mk0000001/ESP32-2424S012-MagSafe-Case/reports/V18/README.md

# V18 프로젝트 보고서와 조립 애니메이션

# V18 Project report and assembly animation

[보고서 PDF / Report PDF](ESP32-2424S012_V18_PROJECT_REPORT_KO_EN.pdf) · [수정용 원문 / Editable source](PROJECT_REPORT.ko-en.md)

[한영 조립 영상 / Korean-English assembly video](../../media/V18/assembly.mp4) · [GIF](../../media/V18/assembly.gif) · [조립 설명 / Assembly instructions](../../docs/ASSEMBLY.ko.md)

한국어 다음 영어 순서. CAD 형상 변경 없음. V18 실물 출력 검증은 남아 있다.

Korean followed by English. CAD geometry is unchanged. Physical V18 print validation remains outstanding.
