mk0000001/ESP32-2424S012-MagSafe-Case/media/V18/README.md

# V18 조립 영상

# V18 Assembly animation

[MP4](assembly.mp4) · [GIF](assembly.gif) · [SRT](assembly.ko-en.srt) · [보고서 / Report](../../reports/V18/)

약 47초, 한글 다음 영어 자막. 실제 V18 케이스 CAD의 조립 동작을 설명한다. 전자부품은 설명용 외형이다.

Approximately 47 seconds, with Korean followed by English captions. It illustrates native V18 case CAD assembly; electronics are explanatory envelopes.
