mk0000001/ESP32-2424S012-MagSafe-Case/cad/V18/README.md

# cad/V18

V18 FreeCAD 원본. BREP는 조립 좌표이고 STL 출력 좌표와 다름.
