mk0000001/ESP32-2424S012-MagSafe-Case/hardware/battery/photos/README.md

# hardware/battery/photos

사용자가 제공한 배터리 식별 사진. 이전 조립물이며V18 출력 사진이 아님.
