mk0000001/ESP32-2424S012-MagSafe-Case/hardware/ESP32-2424S012/photos/README.md

# hardware/ESP32-2424S012/photos

사용자가 제공한 ESP32-2424S012 PCB 사진.
