mk0000001/ESP32-2424S012-MagSafe-Case/cad/V18/brep/README.md

# cad/V18/brep

V18 케이스5종과 조임툴1종의 정밀 BREP. 단위mm,조립 좌표.
