mk0000001/ESP32-2424S012-MagSafe-Case/hardware/battery/YCJ-603048.md

# 배터리 모델 식별

## 사진으로 확인한 값

- 라벨:`YCJ 603048`
- 정격전압:3.7V
- 표시용량:880mAh
- 원산지 표기:`MADE IN CHINA`
- 사용자 실측:50×30×5mm. V18 설계에 적용한 값이다.
- 적색/흑색 전선과 흰색2핀 커넥터가 부착되어 있고, 노란 절연 테이프 안쪽에 소형 기판이 보인다.
- KC마크와 인증 번호 형식의 인쇄가 있으나, 사진의 마지막 문자까지 확정 판독하거나 인증 유효성을 별도로 검증한 것으로 표시하지 않았다.

사진:[정면 라벨](photos/battery-label-user.jpg) · [장착 모습](photos/battery-installed-user.jpg) · [측면](photos/battery-side-user.jpg)

사진은 사용자가 제공한 이전 조립물이다. V18 출력 완료 사진을 의미하지 않는다.

## 같은 사양의 유통 제품 후보

**Coms UB917 — 603048 리튬폴리머 충전지,3.7V,880mAh.**

Coms 공식 목록과 [공식 상세 이미지](https://comsmart.co.kr/productnew/sub21/UB917.jpg)에 모델 코드·전압·용량이 일치한다. 공식 상세 이미지에는 보호회로 내장, 크기30×50×6mm, 전선 길이50mm, 인증표기`ZU10701-17002G`가 실려 있다.

사용자의 주문서/포장에UB917이 표시된 것은 확인하지 못했으므로 **실물 라벨 모델은YCJ603048**, **UB917은 유통 모델 후보**로 기록한다. 같은 공통 모델 코드가 모든 판매자의 커넥터·극성·외형 두께를 보증하지 않는다.

## 치수 차이와 V18

| 기준 | 길이×폭×두께 |
|---|---|
| 사용자 실측/케이스 설계 | 50×30×5mm |
| Coms UB917 판매자 상세 자료 | 50×30×6mm |

V18은 사용자가 장착한5mm 실측 배터리의 흔들림을 줄이기 위해 받침을0.5mm 높였다. 공급자가6mm라고 명시한 대체품은 현재CAD로 검증한5mm 배터리와 구분한다. 사진 속 라벨로부터 실제 두께를 재측정한 것으로 표시하지 않는다.

## 출처

- 사용자 제공 사진,2026-10-30.
- [Coms 공식 상품 목록](https://www.comsmart.co.kr/cmart/shop/list.php?ca_id=f04070)
- [Coms UB917 공식 상세 이미지](https://comsmart.co.kr/productnew/sub21/UB917.jpg)
- [디바이스마트 동일 코드 판매 목록](https://www.devicemart.co.kr/goods/view?no=15808378):유통명 교차 확인용.
