mk0000001/ESP32-2424S012-MagSafe-Case/cad/V17/brep/README.md

# cad/V17/brep

V18 재생성에 사용하는 고정 V17 기준 형상. 출력 추천 버전은 V18.
