mk0000001/ESP32-2424S012-MagSafe-Case/hardware/battery/photos/battery-side-user.jpg

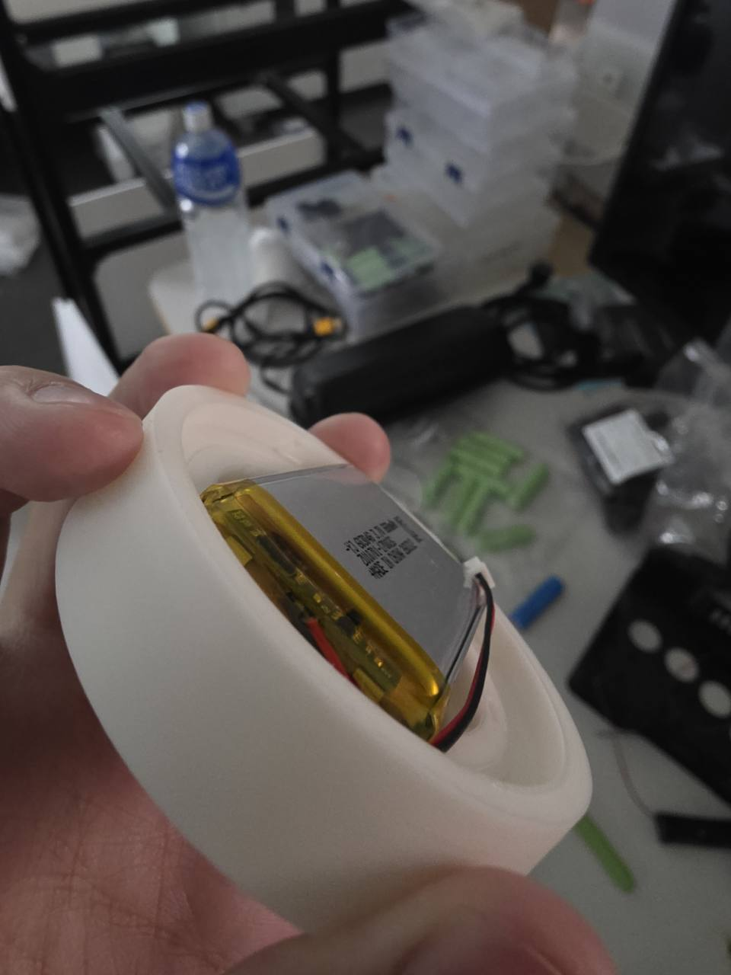
hardware/battery/photos/battery-side-user.jpg
