mk0000001/ESP32-2424S012-MagSafe-Case/hardware/ESP32-2424S012/photos/pcb-user.jpg

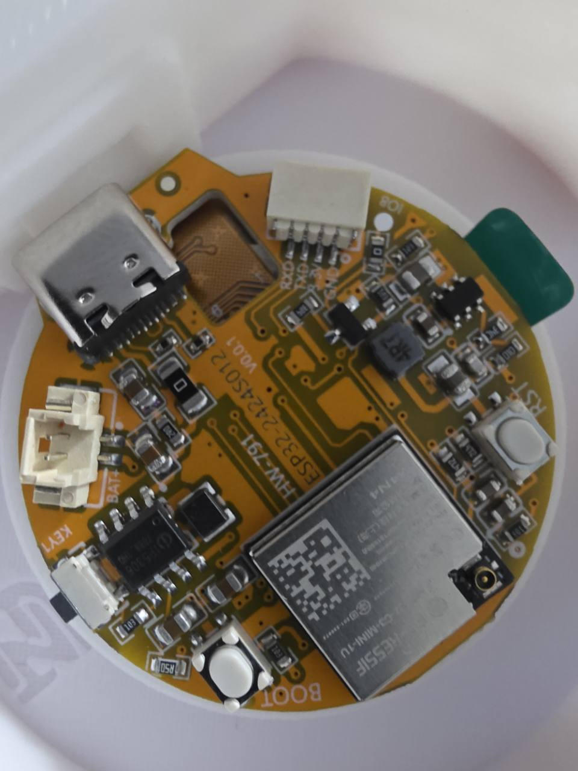
hardware/ESP32-2424S012/photos/pcb-user.jpg
