mk0000001/ESP32-2424S012-MagSafe-Case/cad/V18/ESP32_2424S012_FIT_V18.FCStd

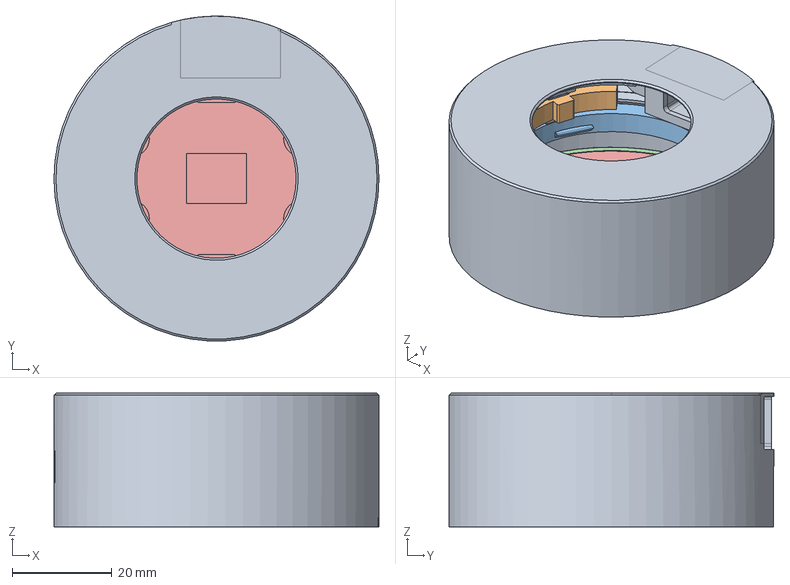
[picture p10: CAD file, 2026-10-30]
cad/V18/ESP32_2424S012_FIT_V18.FCStd
65.3 x 65.3 x 26.8 mm
V18 본체 — USB-C 안쪽 가림벽
V18 보드 받침틀 — V17 호환
V18 보드 고정 링 — 3점 홈 / V17 호환
V18 바깥 뚜껑 — V17 호환
V18 배터리 받침판 — 돌기 +0.5mm / 50.6×30.6mm
