mk0000001/ESP32-2424S012-MagSafe-Case/print/V18/BODY_V18_PRINT.stl

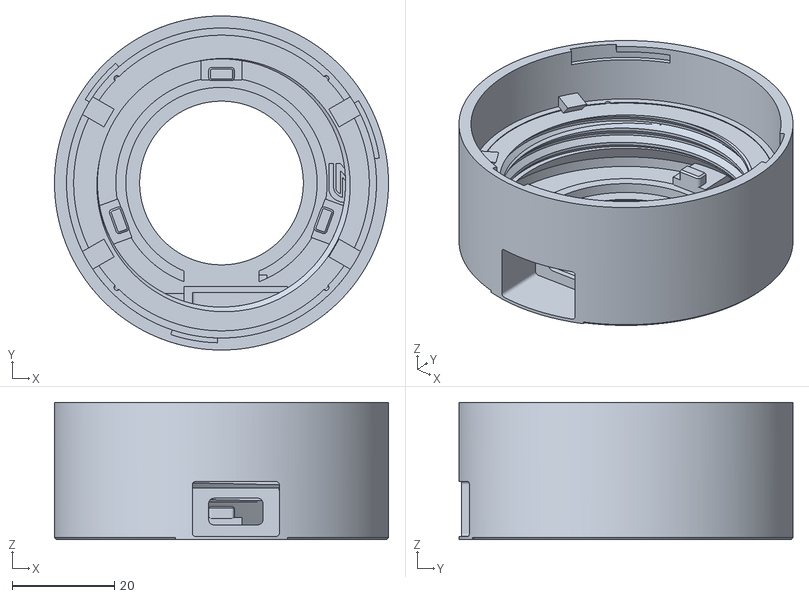
[picture p11: CAD file, 2026-10-30]
print/V18/BODY_V18_PRINT.stl
65.3 x 65.3 x 26.8
