mk0000001/ESP32-2424S012-MagSafe-Case/print/V18/RING_TOOL_3POINT_V18_PRINT.stl

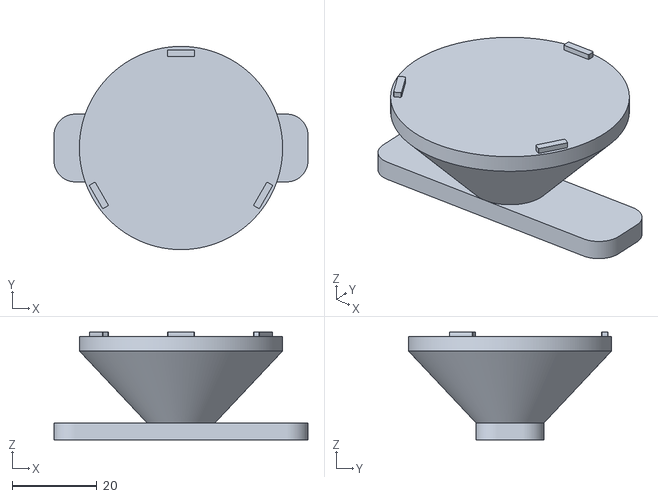
[picture p12: CAD file, 2026-10-30]
print/V18/RING_TOOL_3POINT_V18_PRINT.stl
60.0 x 48.0 x 25.5
