mk0000001/ESP32-2424S012-MagSafe-Case/print/V18/BATTERY_TRAY_INNER_V18_PRINT.stl

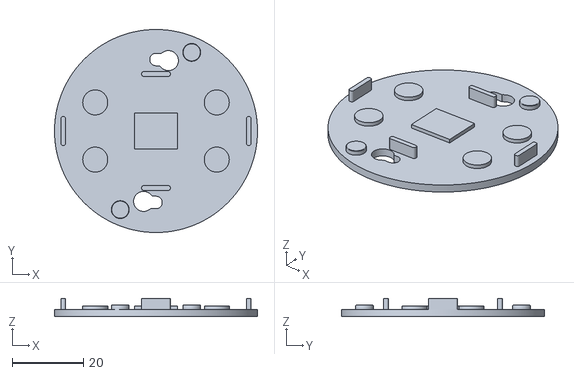
[picture p13: CAD file, 2026-10-30]
print/V18/BATTERY_TRAY_INNER_V18_PRINT.stl
56.8 x 56.8 x 5.10
