mk0000001/ESP32-2424S012-MagSafe-Case/print/V18/BOARD_SUPPORT_FRAME_V18_PRINT.stl

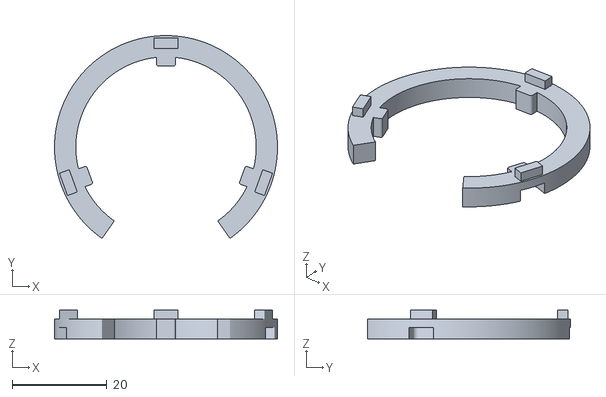
[picture p14: CAD file, 2026-10-30]
print/V18/BOARD_SUPPORT_FRAME_V18_PRINT.stl
47.0 x 42.8 x 6.08
