mk0000001/ESP32-2424S012-MagSafe-Case/print/V18/MAGSAFE_OUTER_LID_V18_PRINT.stl

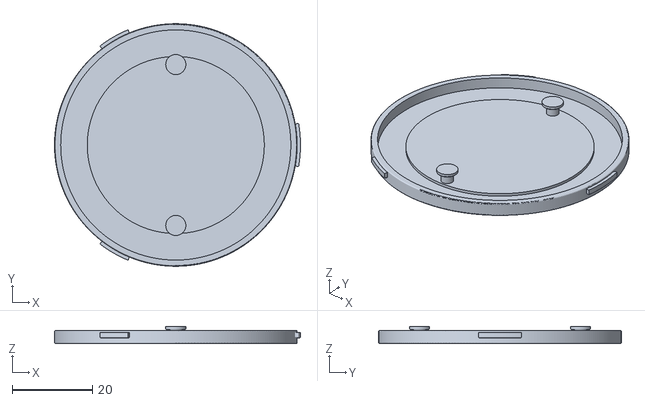
[picture p15: CAD file, 2026-10-30]
print/V18/MAGSAFE_OUTER_LID_V18_PRINT.stl
61.1 x 60.3 x 4.27
