mk0000001/ESP32-2424S012-MagSafe-Case/print/V18/SCREW_RETAINING_RING_3POINT_V18_PRINT.stl

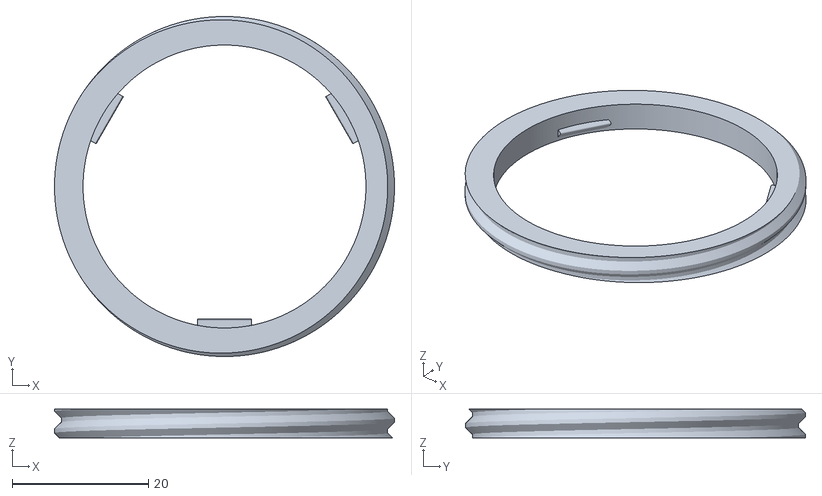
[picture p16: CAD file, 2026-10-30]
print/V18/SCREW_RETAINING_RING_3POINT_V18_PRINT.stl
50.0 x 50.0 x 4.20
