mk0000001/ESP32-2424S012-MagSafe-Case/print/V18/README.md

# print/V18

V18 출력 STL 6개. 각각1개,100% 배율. 본체와 배터리 받침판이 V17에서 변경됨.
