mk0000001/ESP32-2424S012-MagSafe-Case/docs/ASSEMBLY.ko.md

# V18 조립 설명

# V18 Assembly instructions

[조립 영상 / Assembly video](../media/V18/assembly.mp4) · [반복 GIF / Looping GIF](../media/V18/assembly.gif) · [프로젝트 보고서 / Project report](../reports/V18/ESP32-2424S012_V18_PROJECT_REPORT_KO_EN.pdf)

각 단계는 한국어 다음에 영어로 적었다. 회전 방향은 반드시 해당 단계에서 지정한 면에서 본다.

Each step is written in Korean first, then English. Observe every rotation from the viewing side specified in that step.

## 1 본체에 보드 넣기

### Seat the display module

화면을 아래, 노란 PCB를 위로 놓고 USB-C를 본체 충전 구멍에 맞춰 앉힌다.

Place the screen face down with the yellow PCB facing up. Align the USB-C socket with the opening in the body.

## 2 보드 받침틀 넣기

### Fit the board support frame

BOARD_SUPPORT_FRAME의 깊은 홈 3개를 본체 돌기 3개에 맞춰 끝까지 내려 앉힌다.

Align the three deep slots in BOARD_SUPPORT_FRAME with the three body keys and lower the frame onto its seats.

## 3 나사 링으로 보드 고정

### Secure the board with the threaded ring

링을 손으로 먼저 나사산에 맞춘다. 툴 돌기 3개를 링 홈에 끼우고 기기 뒤에서 보아 시계 방향으로 손으로 조인다. 닿아 멈추면 그만 조이고 툴을 빼낸다.

Start the ring on the thread by hand. Engage the three tool pegs and turn clockwise when viewed from the rear of the device. Stop when seated and remove the tool.

## 4 자석 스티커 붙이기

### Attach the magnet sticker

실제 자석이 홈에 들어가는지 먼저 확인한다. 안쪽 배터리 받침판 아래쪽에 붙이고, 흡착 면이 바깥 뚜껑을 향하도록 한다.

Check that the actual magnet fits the recess before bonding it to the underside of the inner battery tray, with its active face toward the outer lid.

## 5 안쪽 배터리 받침판 잠그기

### Lock the inner battery tray

분리한 바깥 뚜껑의 안쪽을 위로 놓는다. 큰 구멍 2개로 기둥 머리를 통과시킨 다음, 뚜껑 안쪽에서 보아 시계 방향 10도로 돌려 좁은 곡선 홈에 건다. 눌러 끼우는 스냅 구조가 아니다.

Place the detached outer lid with its inside facing up. Pass the two post heads through the large holes, then rotate the tray clockwise by 10 degrees when looking into the lid. The heads capture the narrow curved slots; this is a bayonet, not a press-fit snap.

## 6 배터리 넣고 연결

### Fit and connect the battery

50×30×5 mm 배터리를 가이드 안에 놓고 보드 배터리 커넥터에 연결한다. 전선을 안쪽으로 정리해 테두리와 잠금 홈에 끼이지 않게 한다. 배터리를 눌러 찌그러뜨리며 닫지 않는다.

Place the 50×30×5 mm battery inside the guide and connect it to the board. Route the leads inward, clear of the rim and locking tracks. Do not close the case by compressing the battery.

## 7 뚜껑 전체 잠그기

### Lock the complete lid

넓은 돌기 1개를 본체의 넓은 진입 홈에 맞춰 넣는다. 기기 뒤에서 보아 시계 방향 20도로 멈추는 곳까지 돌린다.

Align the one wider lid lug with the wider entry in the body. Turn the complete lid clockwise by 20 degrees when viewed from the rear of the device, up to the stop.

## 열 때

## Disassembly

뚜껑 전체는 기기 뒤에서 보아 반시계 방향 20도, 안쪽 받침판은 분리한 뚜껑 안쪽에서 보아 반시계 방향 10도로 연다. 보드 링을 풀기 전에는 뚜껑과 배터리를 꺼내고 배터리 커넥터를 분리한다.

Open the complete lid counterclockwise by 20 degrees as viewed from the device rear. Open the inner tray counterclockwise by 10 degrees as viewed into the detached lid. Remove the lid and battery and disconnect the battery before loosening the board ring.

안쪽 받침판과 뚜껑 전체는 바라보는 면이 서로 반대다. 보드·배터리·자석·커넥터는 영상에서 위치 설명용 외형이며, 배터리 커넥터 연결은 자막으로 안내한다. V18 실물 체결력은 아직 시험 전이다.

The inner tray and complete lid are viewed from opposite sides. Board, battery, magnet and connector models in the animation are explanatory envelopes. Battery connection is described in captions rather than mechanically animated. Physical V18 fastening force has not yet been tested.
