mk0000001/ESP32-2424S012-MagSafe-Case/media/V18/assembly.gif

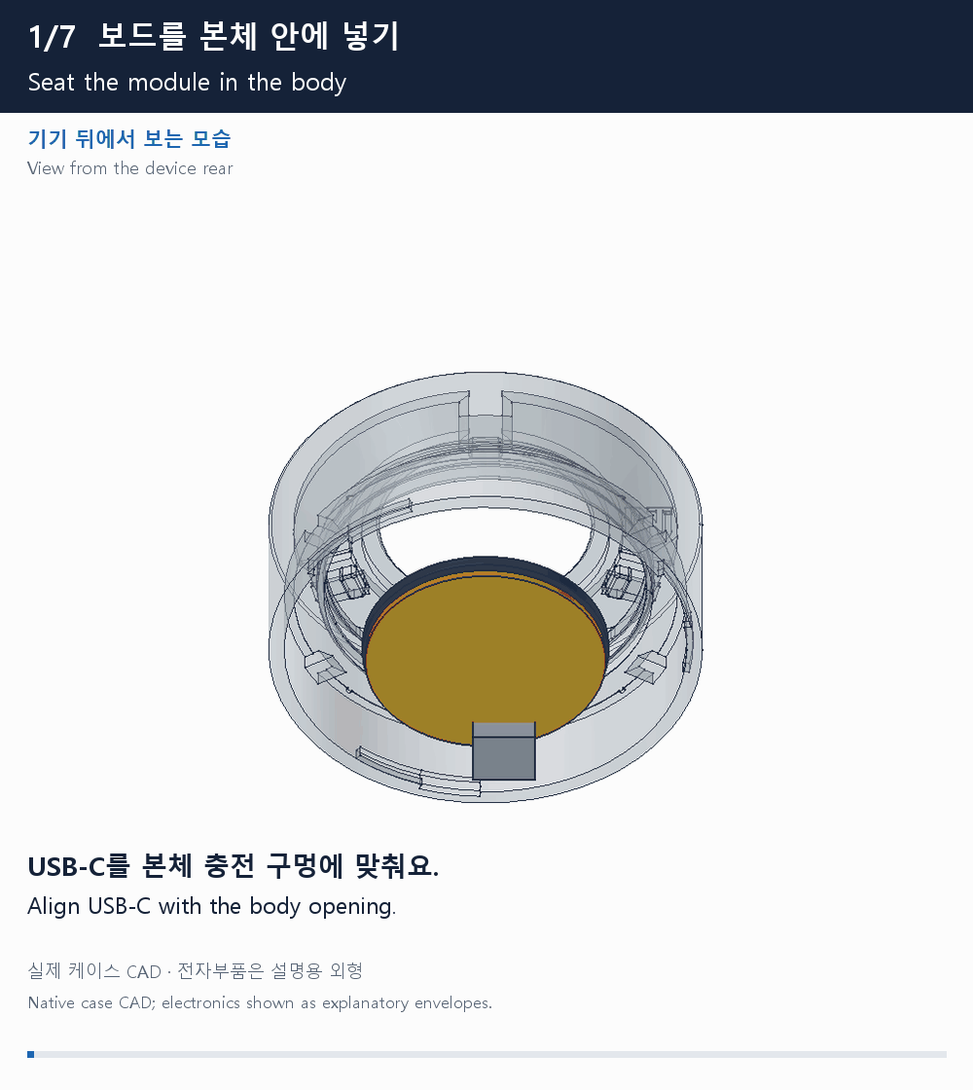
media/V18/assembly.gif
