mk0000001/ESP32-2424S012-MagSafe-Case/CHANGELOG.md

# 변경 이력

## V18 문서 보완 · 2026-10-31

- 10쪽 한국어 다음 영어 프로젝트 보고서 추가.
- 조립 설명과 약 47초 애니메이션 자막을 한국어 → 영어 순서로 정리.
- 저장소 공개 전환, 보고서 포함 최신 전체 묶음을 V18 릴리스와 NAS에 추가.
- CAD와 출력 STL 형상은 변경하지 않음.

## V18 documentation update · 2026-10-31

- Added a ten-page project report with Korean followed by English.
- Updated assembly instructions and approximately 47-second animation captions in the same language order.
- Made the repository public and added an updated complete package to the V18 release and NAS.
- CAD and print STL geometry are unchanged.

## V18 · 2026-10-30

- 배터리 받침 돌기 +0.5mm, 가이드50.6×30.6mm / 높이3.2mm.
- 배터리 위아래 여유0.8→0.3mm.
- USB-C 뒤쪽1.2mm 가림벽과10.6×5.2mm 통과 창 추가.
- 27가지 케이블 삽입 자세, 링·툴 회전, 뚜껑 잠금, 배터리 이동 한계 CAD 확인.
- 조립 영상, 하드웨어 BOM, 사진, 모듈 원본 문서·전체 ZIP 정리.
- 안쪽 받침판의 잠금 방향 설명 정정: 뚜껑 안쪽에서 보아 시계10°.

## V17

- 내부 자석 홈,0.6mm 바깥 플라스틱, 분리형 배터리 받침판.
- 120° 간격3점 링·조임 툴.
- 배터리50×30×5mm, 고정 링 뒤쪽 배치, 깊은 USB-C 케이블 홈.

V17 이전 실험 출력물은 기존 NAS 버전 폴더에 보존했다. 현재 출력 안내는 V18을 기준으로 한다.
