mk0000001/ESP32-2424S012-MagSafe-Case/(commit log)

2026-10-30 docs: organize V18 assembly, hardware BOM and reproducible CAD sources
2026-10-30 docs: add V18 assembly GIF and baseline reference geometry
2026-10-30 feat: publish six validated V18 print parts
    [BATTERY_TRAY_INNER_V18_PRINT.stl, BOARD_SUPPORT_FRAME_V18_PRINT.stl, BODY_V18_PRINT.stl, MAGSAFE_OUTER_LID_V18_PRINT.stl, RING_TOOL_3POINT_V18_PRINT.stl, SCREW_RETAINING_RING_3POINT_V18_PRINT.stl]
2026-10-30 cad: publish V18 FreeCAD assembly
    [ESP32_2424S012_FIT_V18.FCStd]
2026-10-30 cad: add V18 BREP precision geometry
2026-10-30 cad: preserve V17 inputs for reproducible V18 build
2026-10-30 hardware: add user YCJ 603048 battery identification photos
2026-10-30 hardware: add supplied ESP32-2424S012 PCB photo
2026-10-30 hardware: archive original ESP32 module specification
2026-10-30 hardware: preserve ESP32-C3-MINI-1 datasheet
2026-10-30 hardware: archive supplied board schematics
2026-10-30 media: publish V18 assembly video and design views
2026-10-30 validation: publish file hashes and portable CAD rebuild checks
2026-10-30 docs: add Korean then English V18 project report and assembly guide
2026-10-30 media: publish Korean then English assembly animation
